KisleyLabAtCWRU/TExM/README.md

# TExM
Tensile Expansion Microscopy project files: CAD designs, user guides, code
