KisleyLabAtCWRU/TExM/Tracking videos/Video_S2.GIF

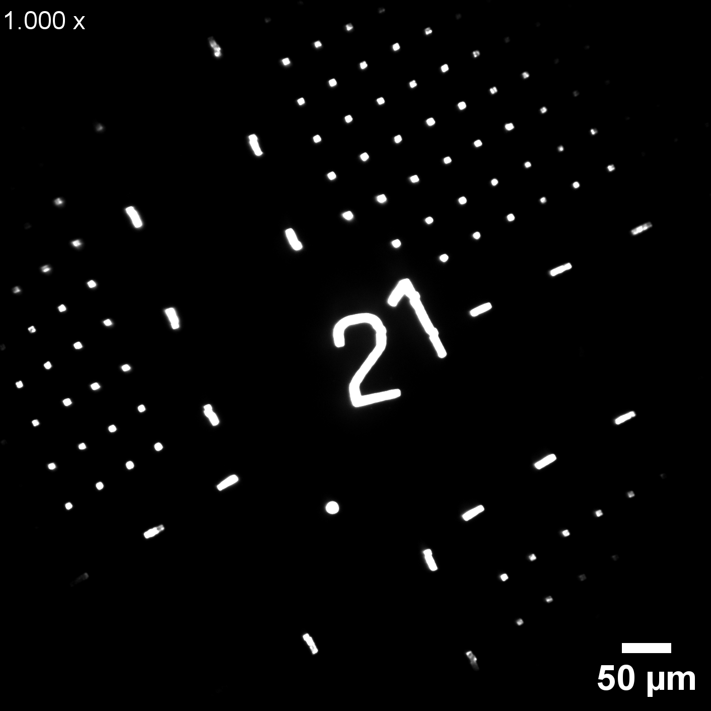
Tracking videos/Video_S2.GIF
