KisleyLabAtCWRU/TExM/CAD/Main - Outer ring.stl

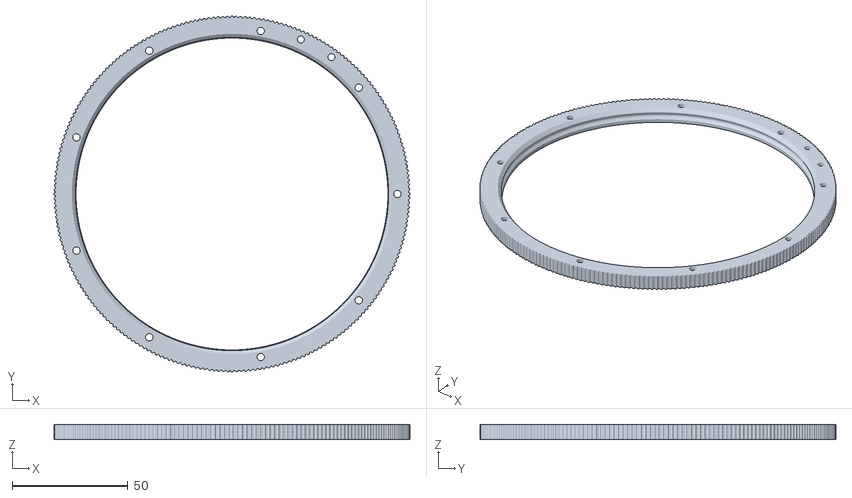
[picture p2: CAD file, 2026-06-04]
CAD/Main - Outer ring.stl
153.7 x 153.7 x 6.35
