KisleyLabAtCWRU/TExM/CAD/Base plate.stl

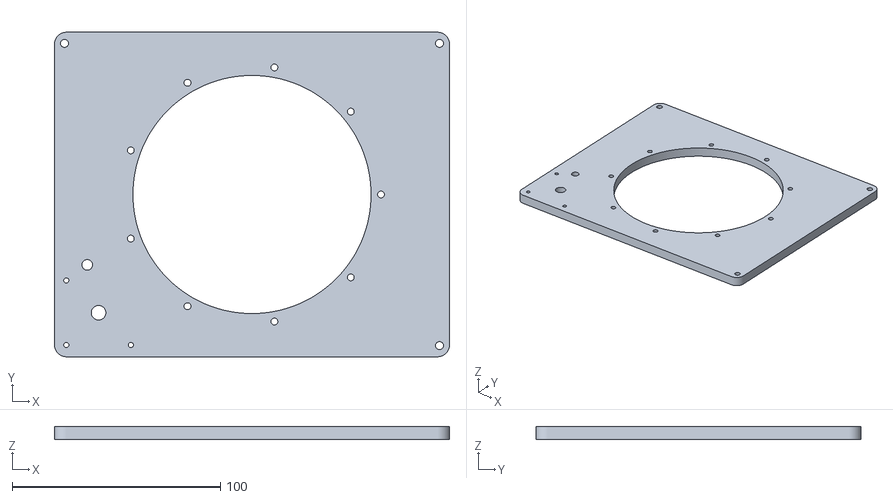
[picture p3: CAD file, 2026-06-29]
CAD/Base plate.stl
189.6 x 155.8 x 6.35
