KisleyLabAtCWRU/TExM/CAD/Belt Tensioner set - Clamp_Fixed_Bottom.stl

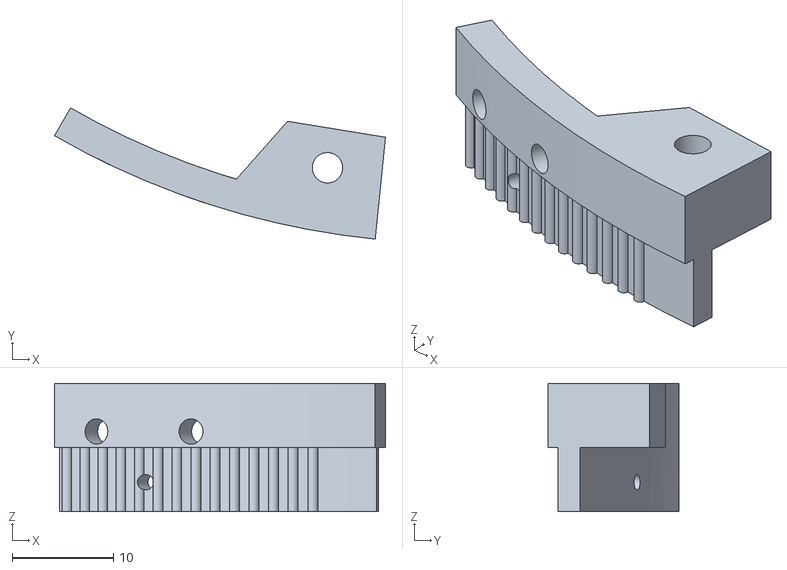
[picture p4: CAD file, 2026-06-04]
CAD/Belt Tensioner set - Clamp_Fixed_Bottom.stl
32.7 x 13.0 x 12.7
