KisleyLabAtCWRU/TExM/CAD/Belt Tensioner set - Clamp_Free_Bottom.stl

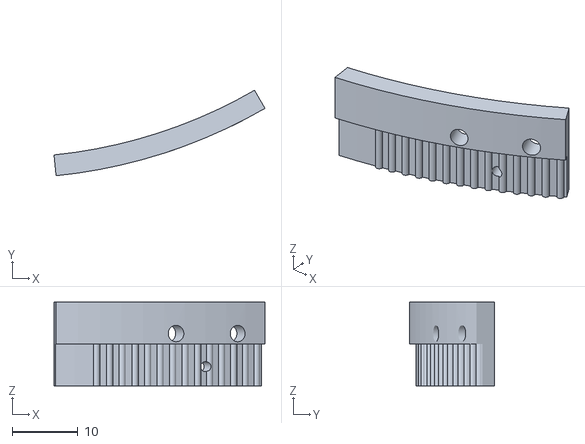
[picture p5: CAD file, 2026-06-04]
CAD/Belt Tensioner set - Clamp_Free_Bottom.stl
32.1 x 13.0 x 12.7
