KisleyLabAtCWRU/TExM/CAD/Inner ring.stl

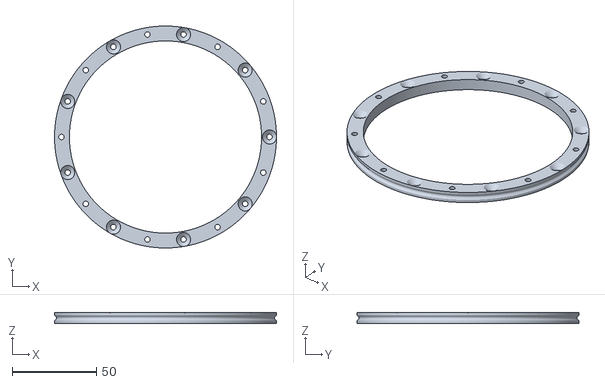
[picture p6: CAD file, 2026-06-04]
CAD/Inner ring.stl
132.1 x 132.1 x 6.35
