KisleyLabAtCWRU/TExM/CAD/Belt Tensioner set - Clamp_Free_Top.stl

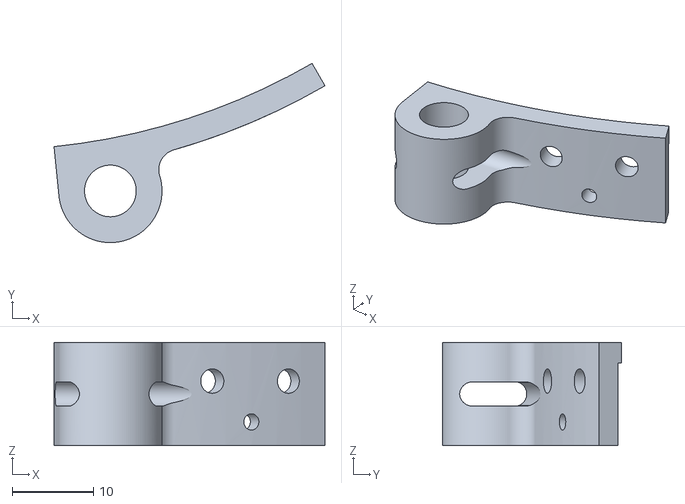
[picture p7: CAD file, 2026-06-04]
CAD/Belt Tensioner set - Clamp_Free_Top.stl
33.3 x 22.0 x 12.7
