KisleyLabAtCWRU/TExM/CAD/Grippers.stl

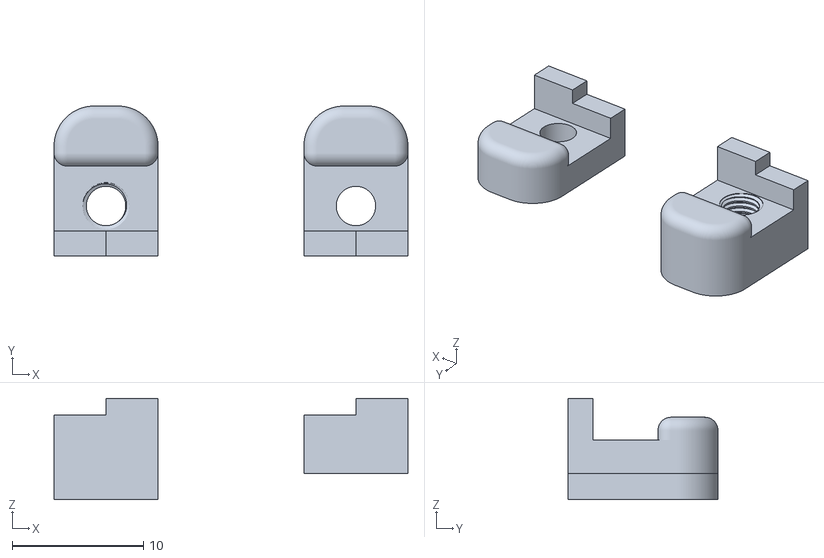
[picture p8: CAD file, 2026-02-20]
CAD/Grippers.stl
27.0 x 11.4 x 7.72
