KisleyLabAtCWRU/TExM/CAD/C-clamp.stl

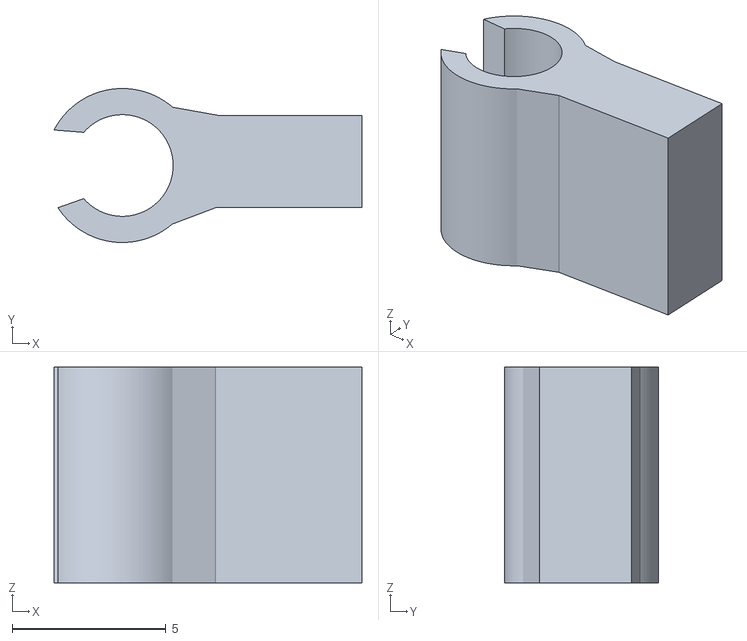
[picture p9: CAD file, 2026-02-20]
CAD/C-clamp.stl
10.0 x 5.00 x 7.00
