KisleyLabAtCWRU/TExM/CAD/Gel mount.stl

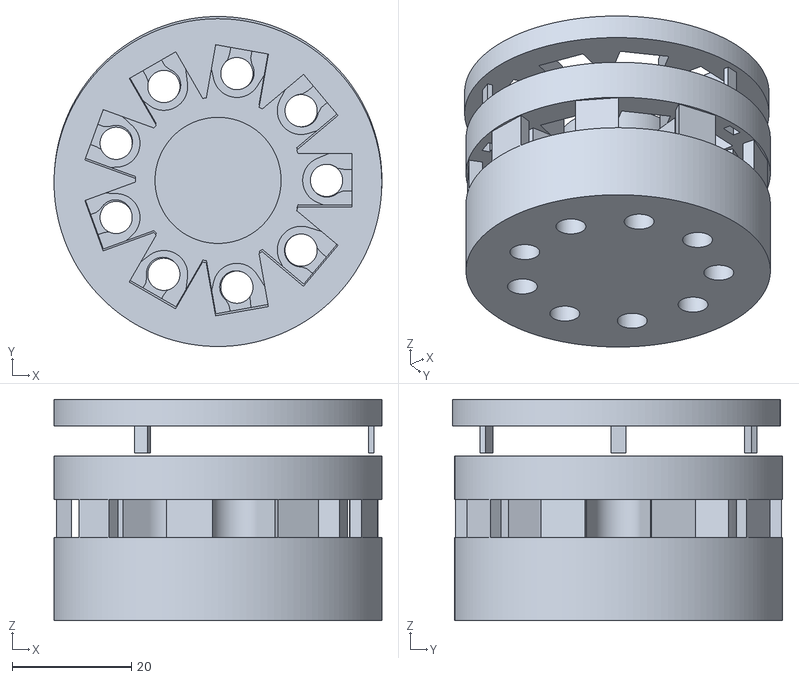
[picture p10: CAD file, 2026-02-20]
CAD/Gel mount.stl
55.0 x 55.4 x 37.2
