KisleyLabAtCWRU/TExM/CAD/Gel cutter_28mm.stl

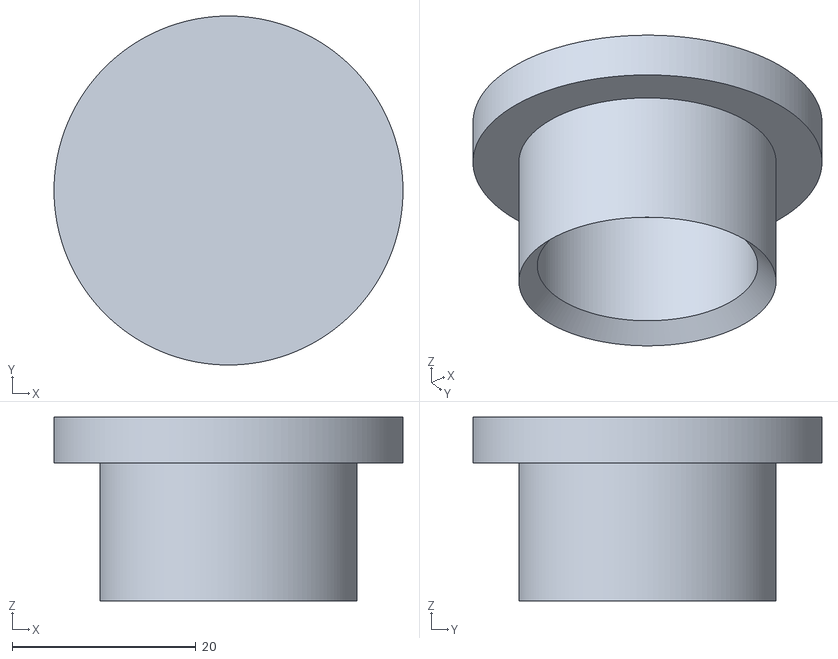
[picture p11: CAD file, 2026-02-20]
CAD/Gel cutter_28mm.stl
38.0 x 38.0 x 20.0
