KisleyLabAtCWRU/TExM/CAD/Drying ring.stl

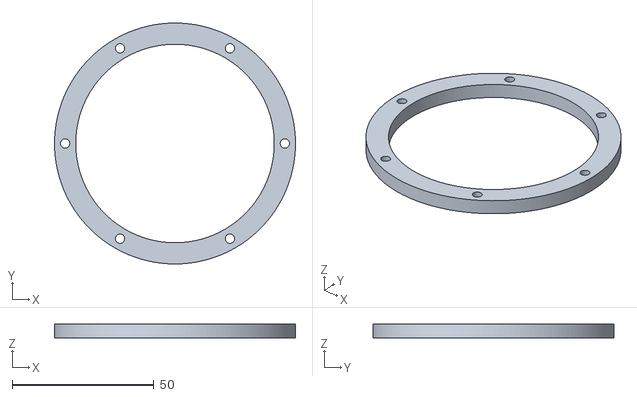
[picture p12: CAD file, 2026-02-20]
CAD/Drying ring.stl
85.0 x 85.0 x 5.00
