KisleyLabAtCWRU/TExM/CAD/Iris_stand.stl

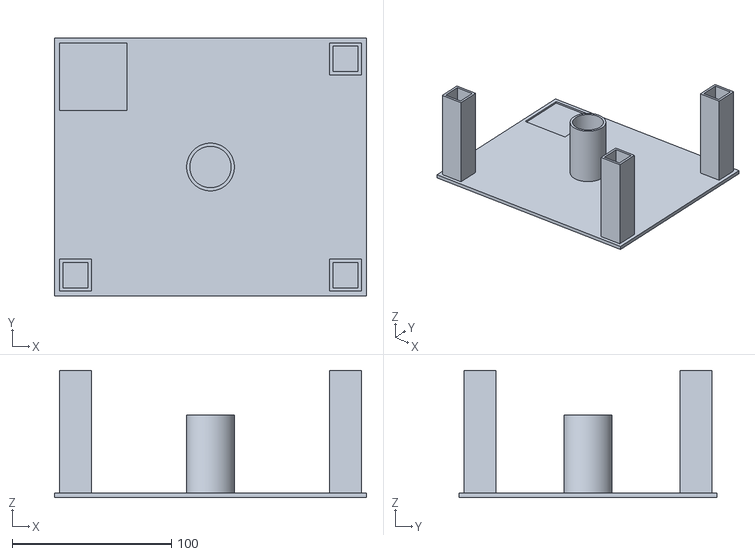
[picture p13: CAD file, 2026-02-20]
CAD/Iris_stand.stl
196.0 x 162.0 x 79.9
