KisleyLabAtCWRU/TExM/(list of files, cad)

Other CAD files:
CAD/Belt Tensioner set - Clamp_Fixed_Top.stl
