KisleyLabAtCWRU/TExM/Code/KisleyIrisStretcher/examples/IrisModule1.0/IrisModule1.0.ino

// IrisModule1.0 — canonical Kisley rig firmware.
//
// Drop-in replacement for the original monolithic IrisModule1.0.ino,
// plus:
//   - 9-channel NAU7802 strain array readout (IrisStrainArray)
//   - "Experiments" LCD submenu with Exp1 (1x → 3.4x CW → 1x) registered
//     and ready to run
//   - Serial commands Xstrain (continuous streaming) / Xrun <name> /
//     Xabort for host-driven experiment control
//
// Hardware: ESP32-S3, HD44780 I2C LCD, rotary encoder, 3 buttons,
// STEP/DIR stepper driver, 9 NAU7802 strain ADCs behind two TCA9548A
// muxes (5 on 0x71 ch0..4, 4 on 0x73 ch0..3).

#include <USB.h>
#include <KisleyIrisStretcher.h>

using namespace kisley::iris;

// ---- Hardware pin map ----
constexpr uint8_t PIN_STEP   = 12;
constexpr uint8_t PIN_DIR    = 13;

constexpr uint8_t PIN_MENU   = A0;
constexpr uint8_t PIN_DOWN   = A1;
constexpr uint8_t PIN_ACCEPT = A2;
constexpr uint8_t PIN_ENC_SW = A3;
constexpr uint8_t PIN_ENC_B  = A4;
constexpr uint8_t PIN_ENC_A  = A5;
constexpr uint8_t PIN_SDA    = 3;
constexpr uint8_t PIN_SCL    = 4;

// ---- Core library components ----
IrisStretcher     stretcher(PIN_STEP, PIN_DIR);
IrisStrainArray   strain;
IrisMenuUI        ui(stretcher, IrisMenuUI::Pins{
                    PIN_MENU, PIN_DOWN, PIN_ACCEPT,
                    PIN_ENC_A, PIN_ENC_B, PIN_ENC_SW,
                    PIN_SDA, PIN_SCL});
IrisSerialConsole    console(stretcher);
IrisExperimentRunner runner(stretcher, strain);

// =====================================================================
// EXPERIMENTS — add new entries here and register them in setup().
// Each `targets` array holds signed Ex values (positive = CW, negative
// = CCW, |Ex| ≤ 1 returns to center). Hold time between waypoints is
// the runner's global setting (default 2000 ms).
// =====================================================================

const float kExp1Targets[] = { 1.0f, 3.4f, 1.0f };
const IrisExperiment kExp1 = { "Exp1", kExp1Targets, 3 };

// Exp2: stepped ramp — 1x → 2x → 1x → 3x → 1x → 3.4x.
// Each pair of waypoints holds for the runner's global hold time
// (default 2 s) before advancing.
const float kExp2Targets[] = { 1.0f, 2.0f, 1.0f, 3.0f, 1.0f, 3.4f };
const IrisExperiment kExp2 = { "Exp2", kExp2Targets, 6 };

void setup() {
  delay(500);
  USB.begin();
  Serial.begin(115200);
  while (!Serial && millis() < 2000) {}

  stretcher.begin();
  stretcher.setStepLogging(false);   // step spam disabled — Xstrain is the data path

  IrisAboutInfo info;
  info.fwName    = "Iris Stretcher";
  info.fwVersion = "v2.0.0";
  info.labLine1  = "Kisley Lab";
  info.labLine2  = "CWRU";
  info.creator   = "Tejasvin Shrikanth";
  info.buildDate = __DATE__;
  info.buildTime = __TIME__;
  ui.setAboutInfo(info);`   Z

  ui.setInvertEncoder(false);
  ui.setUseInternalPulldown(true);
  ui.begin();                        // brings up Wire (SDA=3, SCL=4) + LCD

  // Speed/noise balance tuned for the Kisley rig:
  //   - I2C bus at 50 kHz (5× the safe-default 10 kHz; still well below the
  //     bus's 100 kHz failure point on this wiring)
  //   - NAU7802 conversion rate explicitly pinned at 320 SPS — the chip's
  //     documented maximum. Library already defaults to this; the explicit
  //     call documents the intent and is the right place to dial down if
  //     a future rig needs less noise per sample (e.g. RATE_80SPS).
  //   - mux settle wait set to 0 — TCA9548A switches sub-µs and the
  //     conversion-ready poll is already skipped in the read path, so the
  //     post-route delay buys nothing on this rig. Raise to ~50 µs if you
  //     see occasional bad first-reads after a mux switch.
  //   - 2 raw samples averaged per ADC per CSV row — keeps acquireRow under
  //     ~90 ms so it doesn't visibly stall the motor between log rows
  //     during gotoExpansion. Per-row Bessel stdev is ~2× larger than at
  //     N=8 but motion is smooth. Bump back to 8 for static drift/noise
  //     captures where motion smoothness doesn't matter.
  // Dial setI2cClock(10000) to fall back to safe default if you see I2C errors.
  strain.setI2cClock(50000);
  strain.setSampleRate(NAU7802_RATE_320SPS);
  strain.setMuxSettleMicros(0);
  strain.setSignalAveraging(2);
  ui.showLcdMessage("Initialising the", "ADCs...");
  strain.begin();                    // discovers 9 NAU7802s, runs host-side tare
  ui.refresh();                      // restore the main menu on the LCD

  // Register experiments here. Each call appends to the runner's list
  // and (via attachRunner below) makes it appear in the LCD submenu.
  runner.registerExperiment(kExp1);
  runner.registerExperiment(kExp2);

  // Tell the UI and serial console about the runner so the
  // "Experiments" menu and Xstrain/Xrun/Xabort serial commands work.
  ui.attachRunner(runner);
  console.attachRunner(runner);

  // Lets the Xsignalavg edit screen read + write the strain array's
  // signal-averaging value at runtime.
  ui.attachStrain(strain);
  // Lets the serial console expose XsignalAverage/Xsamplerate (mirrors of
  // the LCD edit screens), so LCD-echoed commands are also re-runnable.
  console.attachStrain(strain);

  // Lets the runner refresh the LCD during motion (gotoExpansion blocks
  // ui.update(), so the runner's step callback is the only opportunity
  // to repaint the current target/step on the screen mid-motion).
  runner.attachUi(ui);

  // One row per ODD motor step: setMotionLogEveryNSteps(2) makes the
  // step callback skip emitRow on even-indexed steps (stepIdx 1, 3, 5,
  // …), so we only block the step loop with the ~90 ms acquireRow on
  // half the pulses. Setting motionLogPeriodMs(0) disables the time
  // gate so the step gate is the only thing throttling emission.
  //
  // Per pair of motor steps:
  //   - stepIdx 0 (odd-numbered):  4 ms pulse + ~90 ms acquireRow
  //   - stepIdx 1 (even-numbered): 4 ms pulse + 0 ms (skipped)
  //   ≈ 98 ms per 2 steps → ~20 steps/sec, ~10 Hz row rate.
  //
  // Compared to the previous "every step" config this is 2× faster
  // motor motion while keeping the same wall-clock data rate. Set
  // setMotionLogEveryNSteps(1) (or remove the call) to log every
  // single step at ~10 steps/sec. Set N=4 / N=10 for sparser captures
  // on longer moves.
  runner.setMotionLogPeriodMs(0);
  runner.setMotionLogEveryNSteps(2);

  console.setBannerLine("|KisleyLab V2.1 |");
  console.begin();
}

void loop() {
  ui.update();
  console.update();
  runner.update();   // drives experiment state machine + strain streaming
}
