KisleyLabAtCWRU/TExM/(commit log)

2026-02-20 CAD folder
2026-02-20 Drying ring
    [Drying ring.stl]
2026-06-09 KisleyIrisStretcherCode
    Will update with newer versions later on. I am committing what currently works on to this.
2026-06-29 Add files via upload
    For CNC/waterjet machining, download this STL then export as DXF to use for those machine.
    [Base plate.stl]
